BerZerKku/BSP-PI_03v1/doc/Плата БСП-ПИ BSP-PI_03v2.pdf

### Ëèñòîâ 1

Ìàññà | Ìàñøòàá
Ïîäï. | Äàòà

Óòâ.

Í.êîíòð.

Ò.êîíòð.

Ïðîâ.

Ðàçðàá.

### Èçì. Ëèñò

×èðêîâ À.Ã.

Íàçàðåíêî À.Í.

Âåðøèíèí À.Ñ.

Ùåáëûêèí Ì.Â.

### № äîêóì

### Ëèñò

### Ëèòåðà

# ÀÂÀÍÒ ÁÑÏ-ÏÈ 03v2 ÑÁ

### Ñáîðî÷íûé ÷åðòåæ

# Ïëàòà BSP-PI_03v2

2

### ÎÎÎ "Ïðîñîôò-Ñèñòåìû"

2. Ïîêðûòèå ïëàòû HASL. | 05.12.13
3. Ïàÿòü ïðèïîåì ÏÎÑ-61 ÃÎÑÒ 21931-76, ýëåìåíòû ïîâåðõíîñòíîãî ìîíòàæà ïàñòîé RM-89 èëè àíàëîãîì.
4. Ýëåìåíòû ïîç. 47, 49, 51, 69 óñòàíàâëèâàòü äî óïîðà â ïëàòó.
5. Ýëåìåíòû ïîç.19 óñòàíàâëèâàòü íà ïðîêëàäêó âûïîëíåííóþ èç îòðåçêà ëåíòû îò ÷èï-ýëåìåíòîâ.
6. Òðåáîâàíèÿ ê ïàéêå ýëåêòðîìîíòàæíûõ ñîåäèíåíèé ïî ñòàíäàðòó IPC-A-610E.
7. Îñòàëüíûå Ò.Ò. ïî ÎÑÒ4.ÃÎ.070.015.
1. *Ðàçìåðû äëÿ ñïðàâîê.

№ | Наименование | Корпус | Кол. | Поз. | Примечание
| | | | | АВАНТ БСП-ПИ 03v2 СП

5

Изм | Лист | № докум. | Подп. | Дата
Разраб. | Щеблыкин М.В | | 05-12-13 | Плата БСП-ПИ 03v2 Спецификация | Лит. | Лист | Листов
Провер. | Вершинин А.С. | | | | | 1 | 3

## ООО «Прософт-Системы»

Н.контр. | Назаренко А.Н.
Утв. | Чирков А.Г.

1 Сборочный чертеж
| АВАНТ БСП-ПИ 03v2 rev.2

ДЕТАЛИ

5 Плата печатная
| BSP-PI_03v2 | 1

ПРОЧИЕ ИЗДЕЛИЯ

Диоды

7 | BAT54S | SOT-23_3 | 2 | VD1,VD2

9 Светодиод KP-1608SGC зеленый
| KINGBRIGHT | 0603 | 2 | VD3,VD4
11 | Cборка NUP2201MR6T1(G) 6В ON | TSOP_6 | 1 | VD5
| Индуктивности

15 Дроссель LQH43CN100K03L 10мкГн
| 650мА MURATA | 1812 | 1 | L1

17 Ферритовая бусина
| BLM31PG601SN1 MURATA | 1206 | 2 | FB1,FB2
19 | Кварц KX-3H 16,0МГц GEYER | 2 pins | 1 | ZQ1 | низкие

21 Кнопка 3ESH9-15 MULTIMEC
| (3FSH9 c толкателем 1S09-16.0 | | | | Толкатель
| (16mm) или 1S11-16.0, | | | | устанавл. при
| 5ESH9 c толкателем 1SS09-16.0) | SMD_4 | 9 | SB1-SB9 | настройке

Конденсаторы

25 | Чип 0805 X7R 50В 0,1мкФ ±10% | 0805 | 14 | C1,C4-C7,C9-C11,C15-C20
27 | Чип 0805 NP0 100В 22пФ ±5% | 0805 | 2 | C2,C3
29 | Чип 1206 X7R 25В 10мкФ ±10% | 1206 | 2 | C8,C12

| | | | | АВАНТ БСП-ПИ 03v2 СП | Лист
5 | | | | | | 2
Изм | Лист | № докум. | Подп. | Дата
31 | Чип 0805 X7R 50В 3600пФ ±5% | 0805 | 1 | C21 | 3600-5100пФ

Микросхемы

35 ATmega128-16AU ATMEL
| (ATmega128A-AU(R) ATMEL) | TQPF_64 | 1 | DD1

37 IDTQS3257Q IDT (SN74CBT3257DBQ

| TI, FST3257QSC FAIRCHILD) | SOIC_16 | 1 | DD2
39 | TMP75AIDR (AID, AIDG4, AIDRG4) TI | SOIC_8 | 1 | DD4
41 | ADuM4160BRWZ (-RL) AD | SOIC_16 | 1 | DD5
43 | FT232RL FTDI | SOIC_28 | 1 | DD6

Разъемы

47 | Вилка на плату IDC-20M | IDC_20 | 1 | X1 | 2.54мм
49 | Вилка на плату IDC-10M | IDC_10 | 3 | X2-X4 | 2.54мм
51 | Вертикальный TYCO-1734366-2 | | | | USB A розетка
| (хуже USBA-1V, USB A 06) | 6 pins | 1 | X5 | на плату

Резисторы

55 | Чип 1206 0Ом ±5% | 1206 | 1 | R5 | Не устанавл.
57 | Чип 1206 4,7Ом ±5% | 1206 | 1 | R3
59 | Чип 1206 24Ом ±1% | 1206 | 2 | R24,R25 | 23-25Ом 1%
61 | Чип 1206 100Ом ±5% | 1206 | 8 | R6,R9-R11,R13,R14,R16,R18
63 | Чип 1206 330Ом ±5% | 1206 | 2 | R20,R21
65 | Чип 1206 10кОм ±5% | 1206 | 6 | R1,R2,R7,R12,R19,R26
67 | Чип 1206 1МОм ±5% | 1206 | 1 | R27

69 Подстроечный 3362P-1-103
| 10кОм ±10% BOURNS | 3 pins | 1 | R4
71 | Чип сборка YC324 100Ом ±5% YAGEO | 1206х4 | 2 | RR1,RR4
73 | Чип сборка YC324 10кОм ±5% YAGEO | 1206х4 | 2 | RR2,RR3

| | | | | АВАНТ БСП-ПИ 03v2 СП | Лист
5 | | | | | | 3
Изм | Лист | № докум. | Подп. | Дата

77 Транзистор IRML2803 N-канальный
| MOSFET IR | SOT-23_3 | 1 | VT1

79 Фильтр DLW21SN900SQ2 50VDC
| 330мА MURATA | 0805_4 | 1 | TV1

## Лист регистрции ревизий СП

№ ревизии | № замененных (измененных) страниц | Дата ревизии | Краткое содержание и причина внесения изменений | Примечание
1 | вновь | 12.03.13
2 | 1,2 | 26.03.13 | Поз.55 не устанавливать. Добавлена замена для поз 39. Поз.21 толкатель устаналивать при настройке.
3 | 2 | 11.03.13 | Элемент поз.69 заменен на аналог другого производителя. Поз. 31 можно устанавливать номиналом от 3600 до 5100пФ.
4 | 1,2 | 17.10.13 | Для поз.21 и 51 добавлены аналоги.
5 | 1-3 | 05.12.13 | Добавлена замена для поз.21 Немного изменено оформление СП.

## Лист регистрции ревизий СБ

№ ревизии | № замененных (измененных) страниц | Дата ревизии | Краткое содержание и причина внесения изменений | Примечание
1 | вновь | 12.03.13
2 | 1 | 05.12.13 | Изменено оформление.
