BerZerKku/BSP-PI_03v1/doc/ЖКИ WG12864A БСП-ПИ.pdf

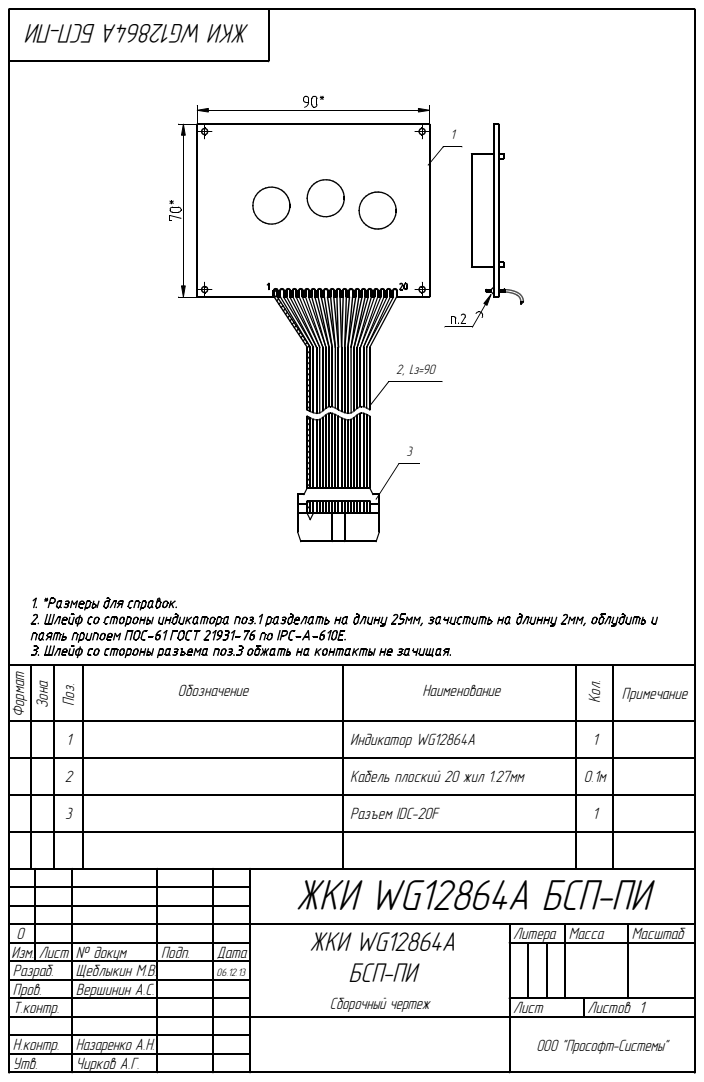
[picture p1: page 1]
Îáîçíà÷åíèå; Ôîðìàò; Çîíà; Ïîç.; Íàèìåíîâàíèå; Êîë.; Ïðèìå÷àíèå; Ðàçúåì IDC-20F; Èíäèêàòîð WG12864A

Êàáåëü ïëîñêèé 20 æèë 1.27ìì

ÆÊÈ WG12864A ÁÑÏ-ÏÈ

0 | | | | ÆÊÈ WG12864A ÁÑÏ-ÏÈ Ñáîðî÷íûé ÷åðòåæ | Ëèòåðà | Ìàññà | Ìàñøòàá
Èçì. | № äîêóì | Ïîäï. | Äàòà Ëèñò
Ðàçðàá. | Ùåáëûêèí Ì.Â. | | 06.12.13
Ïðîâ. | Âåðøèíèí À.Ñ.
Ò.êîíòð. | | | | Ëèñò | Ëèñòîâ 1

Í.êîíòð. | Íàçàðåíêî À.Í.
Óòâ. | ×èðêîâ À.Ã.

ÎÎÎ "Ïðîñîôò-Ñèñòåìû"
