BerZerKku/BSP-PI_03v1/doc/Screen protector.pdf

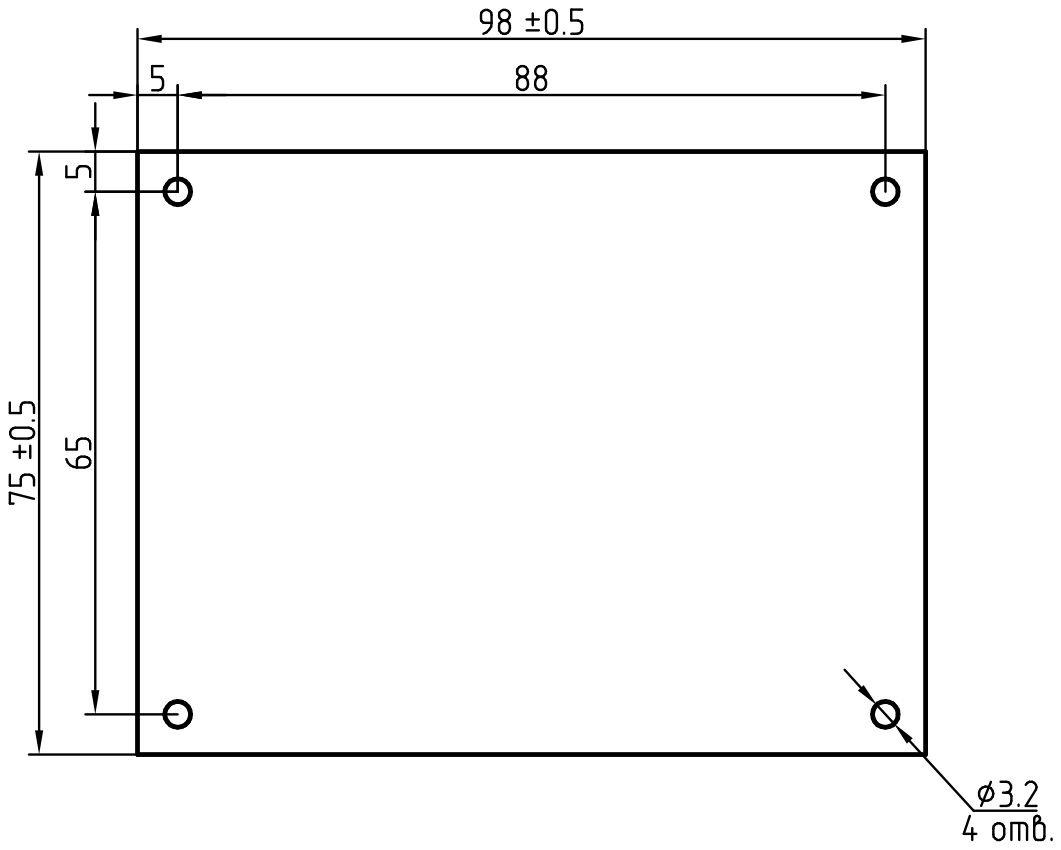
[picture p2: page 1]
