BerZerKku/BSP-PI_03v1/�/PI BSP v3.1 (�).pdf

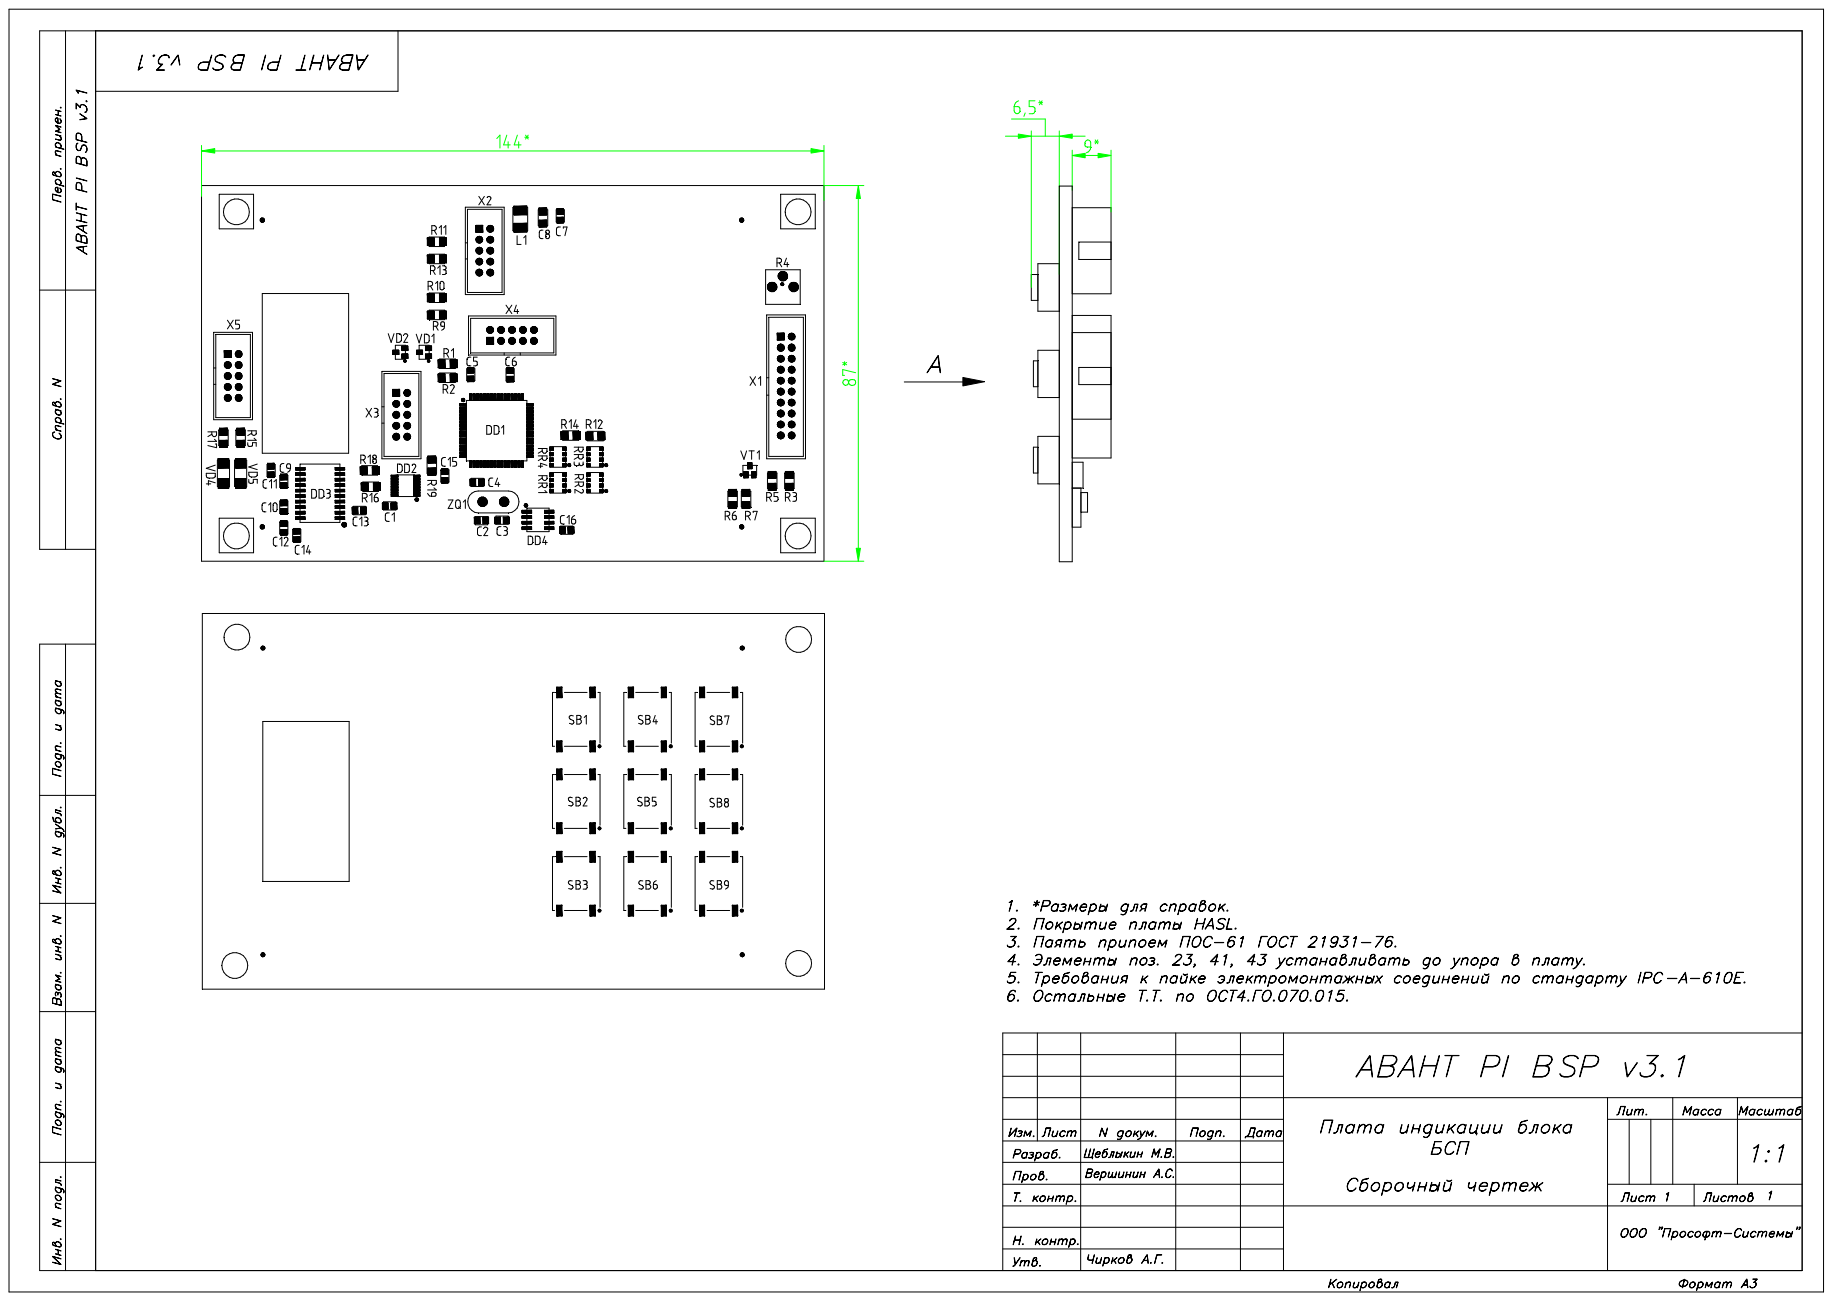
[picture p3: page 1]
