BerZerKku/BSP-PI_03v1/(list of files, drawings)

Other design files:
PI_BSP_V3.DSN
PI_BSP_V3.OLB
pi_bsp_v3.opj
