BerZerKku/BSP-PI_03v1/pcb/art/nc_param.txt

INTEGER-PLACES         3
DECIMAL-PLACES         4
X-OFFSET               0.000000
Y-OFFSET               0.000000
FEEDRATE               1
COORDINATES            ABSOLUTE
OUTPUT-UNITS           METRIC
TOOL-ORDER             INCREASING
REPEAT-CODES           YES
SUPPRESS-LEAD-ZEROES   YES
SUPPRESS-TRAIL-ZEROES  NO
SUPPRESS-EQUAL         YES
TOOL-SELECT            YES
OPTIMIZE_DRILLING      NO
ENHANCED_EXCELLON      YES
TAPE-FILE              E:/ORCAD_sch/RZSK/PI_BSP/v3/pcb/v3.drl
HEADER                 none
LEADER                 12
CODE                   ASCII
SEPARATE               NO
SEPARATE-ROUTING       NO
DRILLING               BY-LAYER
BACKDRILL              NO
CAVITY                 NO
