BerZerKku/BSP-PI_03v1/(commit log)

2012-03-19 Плата индикации на базе графического индикатора 128х64.
    [PI_BSP_V3.OLB, pi_bsp_v3.opj]
2012-03-20 Нарисована часть схемы.
    [PI_BSP_V3.OLB, pi_bsp_v3.opj]
2012-03-21 Схема дорисована. Начаты эксперименты с рамкой.
    [PI_BSP_V3.OLB, pi_bsp_v3.opj]
2012-03-22 Доделана схема / рамка.
    [PI_BSP_V3.OLB, pi_bsp_v3.opj]
2012-04-06 Дорисована схема. Создана заготовка ПП. Расставлены отверстия и кнопки.
    [PI_BSP_V3.OLB, pi_bsp_v3.opj, v3.brd]
2012-04-06 Частично расставлены элементы. Немного подправлена схема. Была ошибка в управлении подсветкой.
    [PI_BSP_V3.OLB, pi_bsp_v3.opj, v3.brd]
2012-04-11 Элементы расставлены, проводники кинуты. Начата прическа платы.
    [PI_BSP_V3.OLB, pi_bsp_v3.opj, v3.brd]
2012-04-11 немного передвинут кварц с обвязкой
    [PI_BSP_V3.OLB, v3.brd]
2012-04-12 Добавлен термодатчик. Причесаны сигнальные слои.
    [PI_BSP_V3.OLB, pi_bsp_v3.opj, v3.brd]
2012-04-12 Начата расстановка шелкографии.
    [pi_bsp_v3.opj, v3.brd]
2012-04-13 Заменены символы IDC-10, 20. Расставлена шелкография.
    [v3.brd]
2012-04-16 Расставлена шелкография, проведена коррекция элементов. Данная версия отдана Боковой Т.И. на тех.контроль.
    [PI_BSP_V3.OLB, v3.brd]
2012-04-16 Предыдущая библиотека нерабочая. Проблема с чип резистором 0 Ом.
    [PI_BSP_V3.OLB]
2012-04-16 Испралвена библиотека, была проблема с чип-резистором 1206 0 Ом.
    [PI_BSP_V3.OLB, pi_bsp_v3.opj]
2012-04-17 Названия площадок по возможности приведены к IPC. Введено поле Кропус у ряда элементов.
    [PI_BSP_V3.OLB, pi_bsp_v3.opj, v3.brd]
2012-04-17 Небольшие коррекции в библиотеке элементов.
    [PI_BSP_V3.OLB, pi_bsp_v3.opj]
2012-04-17 Включена проверка DFA. Немного передвинуты компоненты.
    [v3.brd]
2012-04-18 Вариант 3.1. Плата подготовлена и отправлена на изготовление.
    [pi_bsp_v3.opj, v3.brd, ����� PI BSP v3.1 18 ������ 2012.xls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]
2012-04-19 Исправлено поле Наименование у индуктивности LQH43CN100K03L. Исправлена так же позиция в СП.
    [PI_BSP_V3.OLB, pi_bsp_v3.opj]
2012-04-26 Изменены сборочные слои. Подправлена спецификация, чтобы влезала на 1 страницу. Сделан сборочный чертеж.
    [pi_bsp_v3.opj, v3.brd, �� ��� v3 rev1.dwg]
2012-04-27 Исправлена схема и разводка разъема программирования X3 ISP.
    [pi_bsp_v3.opj, v3.brd]
2012-10-22 Начато восстановление схемы.
    [PI_BSP_V3.DSN, pi_bsp_v3.opj]
2012-10-22 Схема практически восстановлена.
    [PI_BSP_V3.DSN]
2012-10-22 Исправлена часть ошибок на схеме.
    [PI_BSP_V3.DSN, pi_bsp_v3.opj]
2012-10-23 Схема восстановлена! Исправлено название футпринта для TMP75 в библиотеке.
    [PI_BSP_V3.DSN, PI_BSP_V3.OLB, pi_bsp_v3.opj]
2012-10-23 Часть элементов заменена на эл-ты из базы.
    [PI_BSP_V3.DSN, pi_bsp_v3.opj, v3.brd]
2012-10-26 Частично расставлена/разведена USB часть. Добавлен резистор на FTDI TXD.
    [PI_BSP_V3.DSN, pi_bsp_v3.opj, v3.brd]
2012-10-29 Добавлены резистор + конденсатор на змелю с корпуса USB. По идее плата разведена, нужна проверка и прическа.
    [PI_BSP_V3.DSN, pi_bsp_v3.opj, v3.brd]
2013-01-23 Изменен ADuM4160, была ошибка в названии и описании элемента.
    [PI_BSP_V3.DSN, pi_bsp_v3.opj, v3.brd]
2013-01-31 Добавлены производственные файлы.
    [PI_BSP_V3.DSN, pi_bsp_v3.opj, v3.brd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]
2013-01-31 Добавлены файлы настроек.
    [art_param.txt, nc_param.txt]
2013-02-01 Из файлов заказа убран слой SILK_BOT.
2013-02-01 Небыл залит полигон под DD6 -> отсутствовала связб 26 пина с землей. Зазоры полигона на слое TOP с SMD уменьшены до 0.2.
    [v3.brd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]
2013-02-01 В течении предыдущего коммита небыл сохранен файл pcb.
    [v3.brd]
2013-02-28 Добавлены чертежы защитной пленки.
    [�������� ������.dwg]
2013-03-12 Добавлена документация для монтажа.
    [v3.brd, �� ��� v3 rev1.dwg, ����� ���-�� BSP-PI_03v2 (��).dwg, �������� ������.dwg]
2013-03-12 Убраны настройки слоев.
2013-03-12 Документация подправлена согласно требованиям нормоконтроля.
    [pi_bsp_v3.opj, ����� ���-�� BSP-PI_03v2 (��).dwg]
2013-03-12 Исправлены ТТ на СБ в соответствии с изменненными поз.обозначениями в СП.
    [����� ���-�� BSP-PI_03v2 (��).dwg]
2013-03-26 СП рев.2 Требует доделки.
2013-03-27 Добавлены замены для температурного датчика.
2013-07-03 Исправлены названия русскоязычных файлов/папок.
    [Screen protector.dwg, art_param.txt, nc_param.txt, Плата BSP-PI_03v2 (СБ).dwg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]
2013-10-11 СП rev.3 Элемент поз.69 заменен на аналог другого производителя (подстроечник MURATA на BOURNS). Поз. 31 можно устанавливать ть номиналом от 3900 до 5100пФ.
    [pi_bsp_v3.opj]
2013-10-11 СП rev.3 Поз. 31 можно устанавливать ть номиналом от 3600 до 5100пФ.
2013-10-14 Для защитной пленке проставлена привязка отверстий к верхнему левому углу. Диаметры отверстий увеличины до 3.2мм.
    [Screen protector.dwg]
2013-10-17 СП rev.3 Добавлены аналоги для позиций 21 и 51. Позиция 21 добавлены кнопки и колпачки как в отделе ДЭСАУР. Позиция 51 добавлены разъемы USB как в отделе ДЭСАУР, Казаринов сказал что у них фиксирован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
2013-10-17 СП rev.4 Предыдущее сохранение относилось к ревизии 4.
2013-12-05 Изменены названия документов. Добавлены pdf для спецификации и общая.
    [Плата BSP-PI_03v2 (СБ).dwg, Плата БСП-ПИ BSP-PI_03v2 (СБ).dwg]
2013-12-05 В СП добавлено название пункта "ПРОЧИЕ ИЗДЕЛИЯ".
2013-12-05 Укорочено название для кнопки до 5ESH9.
2013-12-05 На СБ убрана лишняя текстовая надпись.
    [Плата БСП-ПИ BSP-PI_03v2 (СБ).dwg]
2013-12-06 Добавлена документация для распайки ЖКИ
    [ЖКИ WG12864A БСП-ПИ.dwg]
